LeonardoRedaelli1999/BeeSmart/Sensors/SD/DS18B20_and_DHT_SD.ino

// Libraries for DS18B20
#include <OneWire.h>
#include <DallasTemperature.h>
// Libraries for DHT11/22
#include <Adafruit_Sensor.h>
#include <DHT.h>
#include <DHT_U.h>
// Libraries for comunicating with the SD
#include <SPI.h>
#include <SD.h>
File myFile;

// Initialize the commands for SLEEP to save energy
//ISR(WDT_vect) { Sleepy::watchdogEvent(); }

// Sensor type for the humidity sensor
#define DHTTYPE DHT11   // DHT 11
// Data wire bus for DS18B20 in digital pin 2
#define ONE_WIRE_BUS 2
// Humidity sensor DHT INSIDE (pin 3) and OUTSIDE (pin 4) the beehive
#define DHT_IN_PIN 3
#define DHT_OUT_PIN 4
#define LEDpin 13

// Setup a oneWire instance to communicate with any OneWire device
OneWire oneWire(ONE_WIRE_BUS);
// Pass oneWire reference to DallasTemperature library for DS18B20
DallasTemperature sensors(&oneWire);


// Number of temperature/humidity sensors PREDEFINED
const int numDS18B20 = 5;
const int numDHT = 2;

// BRUTTO float numbers require 2byte, we could save the measurements instantly as integer types (int=measurement*100)
float tempC[numDS18B20]; //12 significant bits

// BRUTTO Addresses of DS18B20 sensors retrived with the Sensor_Identifier_DS18B20.ino program. This procedure can be AUTOMATIZED for a large scale production 
DeviceAddress address_T1 = {0x28, 0x96, 0x25, 0x46, 0x5F, 0x20, 0x01, 0x65}; // T1=CLUSTER of bees
DeviceAddress address_T2 = {0x28, 0x3E, 0xA8, 0x93, 0x63, 0x20, 0x01, 0x5A}; // T2=LEFT or EST STOCKS
DeviceAddress address_T3 = {0x28, 0xE2, 0x8A, 0x7A, 0x62, 0x20, 0x01, 0xE9}; // T3=RIGHT or OVEST STOCKS
DeviceAddress address_T4 = {0x28, 0x65, 0x7B, 0x5C, 0x5F, 0x20, 0x01, 0x5A}; // T4=CLUSTER of bees (safety)
DeviceAddress address_T5 = {0x28, 0x49, 0x7C, 0x51, 0x5F, 0x20, 0x01, 0x5D}; // T5=OUTSIDE

//float temperature[numDHT]; // Temperature measured from the DHT, not needed since we used sensors T1 T2 T3 T4 T5
float humidity[numDHT];

// Initialize the DHT sensors INSIDE and OUTSIDE the beehive
DHT_Unified dht_in(DHT_IN_PIN, DHTTYPE);
DHT_Unified dht_out(DHT_OUT_PIN, DHTTYPE);


void setup(void)
{
  // Start up the library for DS18B20 and for DHT
  sensors.begin();
  dht_in.begin();
  dht_out.begin();
  Serial.begin(9600);
  
  // Check visually for the power light (spia di accensione)
  pinMode(LEDpin, OUTPUT);
  digitalWrite(LEDpin,HIGH);
  delay(2000);
  if (!SD.begin(10)) {
    // If SD initialization didn't go as planned the light stay on
    while (1);
  }
  digitalWrite(LEDpin, LOW);
  
  // BRUTTO We saves datas on a MicroSD so we could send them via LoRa only once a day
  // However if the battery ended or for every inconvenient crash we should send all the datas that probably wasn't able to send
}

void loop(void)
{ 
  // Send command to all DS18B20 for temperature conversion
  sensors.requestTemperatures();
  
  // Get temperature from a specified sensor (position of sensors is physically written on the sensor), in order to keep track for the physical position of sensors
  tempC[0] = sensors.getTempC(address_T1);
  //delay(200);
  tempC[1] = sensors.getTempC(address_T2);
  //delay(200);
  tempC[2]= sensors.getTempC(address_T3);
  //delay(200);
  tempC[3] = sensors.getTempC(address_T4);
  //delay(200);
  tempC[4] = sensors.getTempC(address_T5);
  //delay(200);
  
  // Display the temperature values in order to test/debug
  for (int i = 0;  i < numDS18B20;  i++)
  {
    // BRUTTO Serial.print always try to print even though Arduino is not connected to a Serial Monitor?????????????????
    Serial.print("Sensor T");
    Serial.print(i+1);
    Serial.print(" : ");
    Serial.print(tempC[i]);
    Serial.print("C ");
  }
  
  Serial.println("");
  
  // BRUTTO Not optimized from a memory point of view, since sensors_event_t is a ~40byte data and we only need a 2byte float
  sensors_event_t event;
  
  // Get humidity and print its value
  dht_in.humidity().getEvent(&event);
  if (isnan(event.relative_humidity)) {
    // BRUTTO Serial.print(F()) using F() we are moving constant strings to the program memory instead of the ram
    Serial.println(F("Error reading humidity IN!"));
    // BRUTTO TRY FOR SOME TIME AND IF IT DOESN'T RESPOND THAN ALWAYS RETURN AN ERROR VALUE AND CALL IT NO MORE
  }
  // Display the humidity values in order to test/debug
  else {
    humidity[0]=event.relative_humidity;
    Serial.print(F("Humidity in: "));
    Serial.print(humidity[0]);
    Serial.println(F("%"));
  }
  
   // Get humidity and print its value
  dht_out.humidity().getEvent(&event);
  if (isnan(event.relative_humidity)) {
    // BRUTTO Serial.print(F()) using F() we are moving constant strings to the program memory instead of the ram
    Serial.println(F("Error reading humidity OUT!"));
    // BRUTTO TRY FOR SOME TIME AND IF IT DOESN'T RESPOND THAN ALWAYS RETURN AN ERROR VALUE AND CALL IT NO MORE
  }
  // Display the humidity values in order to test/debug
  else {
    humidity[1]=event.relative_humidity;
    Serial.print(F("Humidity out: "));
    Serial.print(humidity[1]);
    Serial.println(F("%"));
  }
    
  // FILE_WRITE starts from the end of the file to read/save datas
  // BRUTTO Save in this order: the 5 temperature, the 2 humidity and the percentual of activation of the PIR
  myFile = SD.open("test.txt", FILE_WRITE);
  
  // myFile = TRUE if it has been opened correctly
  if (myFile) {
    for (int i = 0; i < numDS18B20; i++) {
    myFile.println(tempC[i]);
    }
    for (int i = 0; i < numDHT; i++) {
    myFile.println(humidity[i]);
    }
    //myFile.println(percPIR);
    
  myFile.close();
  }
  
  
  delay(10000);
}
