LeonardoRedaelli1999/BeeSmart/(commit log)

2021-10-25 Rename Sensors/DHT_nonblocking.ino to Sensors/Temperature and Humidity/DHT_nonblocking.ino
2021-10-25 Rename Sensors/Temperature and Humidity/DHT_nonblocking.ino to Sensors/DHT_nonblocking.ino
2021-10-27 Rename Sensors/SD/Generic_Code_for_SD/SD_Reading_Files.ino to Sensors/SD/Generic Code for SD/SD_Reading_Files.ino
2021-10-27 Rename Sensors/SD/Generic_Code_for_SD/SD_Saving_Files.ino to Sensors/SD/Generic Code for SD/SD_Saving_Files.ino
2021-10-27 Rename Sensors/SD/TestSD_DS18B20_and_DHT_SD.ino to Sensors/SD/TEST with SD/TestSD_DS18B20_and_DHT_SD.ino
